dickoff/esp32-color-lamp-stand/README.md

# Color Lamp Stand — User Guide

This illuminated stand connects to Wi-Fi and uses its 32 LEDs to show whether
a stock selected in the firmware is up or down: green for up, red for down, and
white when no current value is available. The stock cannot currently be changed
through the Wi-Fi setup page.

This is the default behavior, but you could modify the software to do something
completely different or custom with the LEDs and the Internet connection.

## Hardware

You need:

- A USB-C wall charger and a USB-C-to-USB-C cable. For full brightness, use a
  charger that provides **5 V at 3 A**.

Good options are:

- This [Anker 20 W USB-C charger kit](https://www.amazon.com/dp/B0CP7NWH6L),
  which includes two compact chargers and two cables. Each charger provides
  5 V at 3 A.
- The inexpensive [IKEA SJÖSS 20 W USB-C charger](https://www.ikea.com/us/en/p/sjoess-20w-1-port-usb-charger-10618445/),
  which also provides 5 V at 3 A. Its USB-C cable is sold separately.

Either option provides enough power for the stand's highest brightness setting.
A computer USB-C port also works, but the stand may automatically use a lower
brightness if the port advertises less available current.

Feed the cable through the base and tie a loose knot inside for strain relief,
as shown below. Do not pull the knot tight enough to damage the cable.

Knot in USB-C cable for strain relief

Connect the USB-C plug to the socket on the circuit board.

USB-C cable plugged into the circuit board

Fit the translucent cover, then place the object you want to illuminate on top.

## Wi-Fi configuration

On first use, an amber wave travels around the stand and it creates a temporary
Wi-Fi network named
`ColorLamp-Setup-XXXX`, where the last four characters are unique to your stand.

1. On a phone, tablet, or computer, open Wi-Fi settings and join that network.
   It intentionally has no password and may be described by your device as
   having no internet.
2. The setup page should open automatically. If it does not, open
   [http://192.168.4.1](http://192.168.4.1) in a web browser.
3. Select your home Wi-Fi network, enter its password, and choose **Connect**.
4. The stand pulses blue while it tests the connection. Green means setup
   succeeded and the stand will restart. Red means it could not connect; check
   the network and password, then try again.

Your Wi-Fi password is stored only on the stand.

### Changing the Wi-Fi network

With the stand fully started, hold the **BOOT** button on the circuit board for
five seconds. The LEDs turn red, the saved Wi-Fi details are erased, and the
stand restarts in setup mode.

Do not hold **BOOT** while plugging in power or pressing **RESET**. That button
also activates the ESP32's programming mode during startup.

## What the lights during startup mean

Every startup shows the power check, then the firmware version, then the Wi-Fi
status.

### Power check

Immediately after power-on, a short sweep reports how much current the connected
USB-C source advertises. The stand uses this information to limit LED brightness.
The sweep fills, pauses for about a second, and fades away.

USB-C power capability light patterns

- **8 amber LEDs — USB default:** The stand uses a conservative, low-brightness
  limit. For better illumination, try a USB-C charger rated for at least 1.5 A.
- **16 cyan LEDs — 1.5 A:** Normal operation with good available brightness.
- **32 green LEDs — 3 A:** The source advertises the highest supported current.
- **Two red flashes, then 8 amber LEDs:** The stand could not read the source
  capability and safely selected the conservative limit.

This is the capability advertised by the power source, not a measurement of how
much current the stand is presently consuming.

### Firmware version

After the power check, three short displays show the firmware version in
**major.minor.patch** order. Count only the **bright white LEDs** in each display.
The rest of the ring glows dimly in a background color to identify the part:

- **Blue background:** Major version.
- **Purple background:** Minor version.
- **Amber background:** Patch version.

For example, version **2.2.0** shows two white LEDs on blue, two white LEDs on
purple, then an entirely dim amber ring. **No white LEDs means zero**—the colored
background still appears.

### Wi-Fi and setup

After the version display, the entire perimeter shows the Wi-Fi state.

Wi-Fi setup and connection light patterns

- **Solid blue:** Connecting to the saved Wi-Fi network.
- **Slow amber wave (one lap every four seconds):** Waiting for you to join
  `ColorLamp-Setup-XXXX` and complete setup.
- **Pulsing blue:** Testing the Wi-Fi name and password you entered.
- **Solid green:** Connected successfully. After initial setup, the stand soon
  restarts automatically.
- **Solid red:** The attempted Wi-Fi connection failed.
- **Bright red after holding BOOT:** Saved Wi-Fi details are being erased.

## Troubleshooting

- **The setup page did not open:** Stay connected to `ColorLamp-Setup-XXXX` and
  open [http://192.168.4.1](http://192.168.4.1) manually. Temporarily disabling
  cellular data or a VPN can help if the phone leaves the setup network.
- **The stand keeps returning to amber setup mode:** Re-enter the Wi-Fi password
  and make sure the selected network is available where the stand will be used.
- **The light is unusually dim:** Check the power-on sweep. Eight amber LEDs mean
  the power source advertised only the default USB current; try another USB-C
  charger and cable.
- **You need to start over:** Let the stand finish booting, then hold **BOOT** for
  five seconds.

## Want to modify it?

The hardware and especially firmware are open for experimentation. See the
[modification guide](MODIFYING.md) for the source layout, fixed GPIO assignments,
KiCad design overview, and build workflow.

If you're working with an AI coding agent, point it at this repository and ask
it to read [MODIFYING.md](MODIFYING.md) before making changes.
