dickoff/esp32-color-lamp-stand/pcb/esp32-color-lamp-stand.kicad_pcb

## KiCad design pcb/esp32-color-lamp-stand.kicad_pcb (2026-09-15)

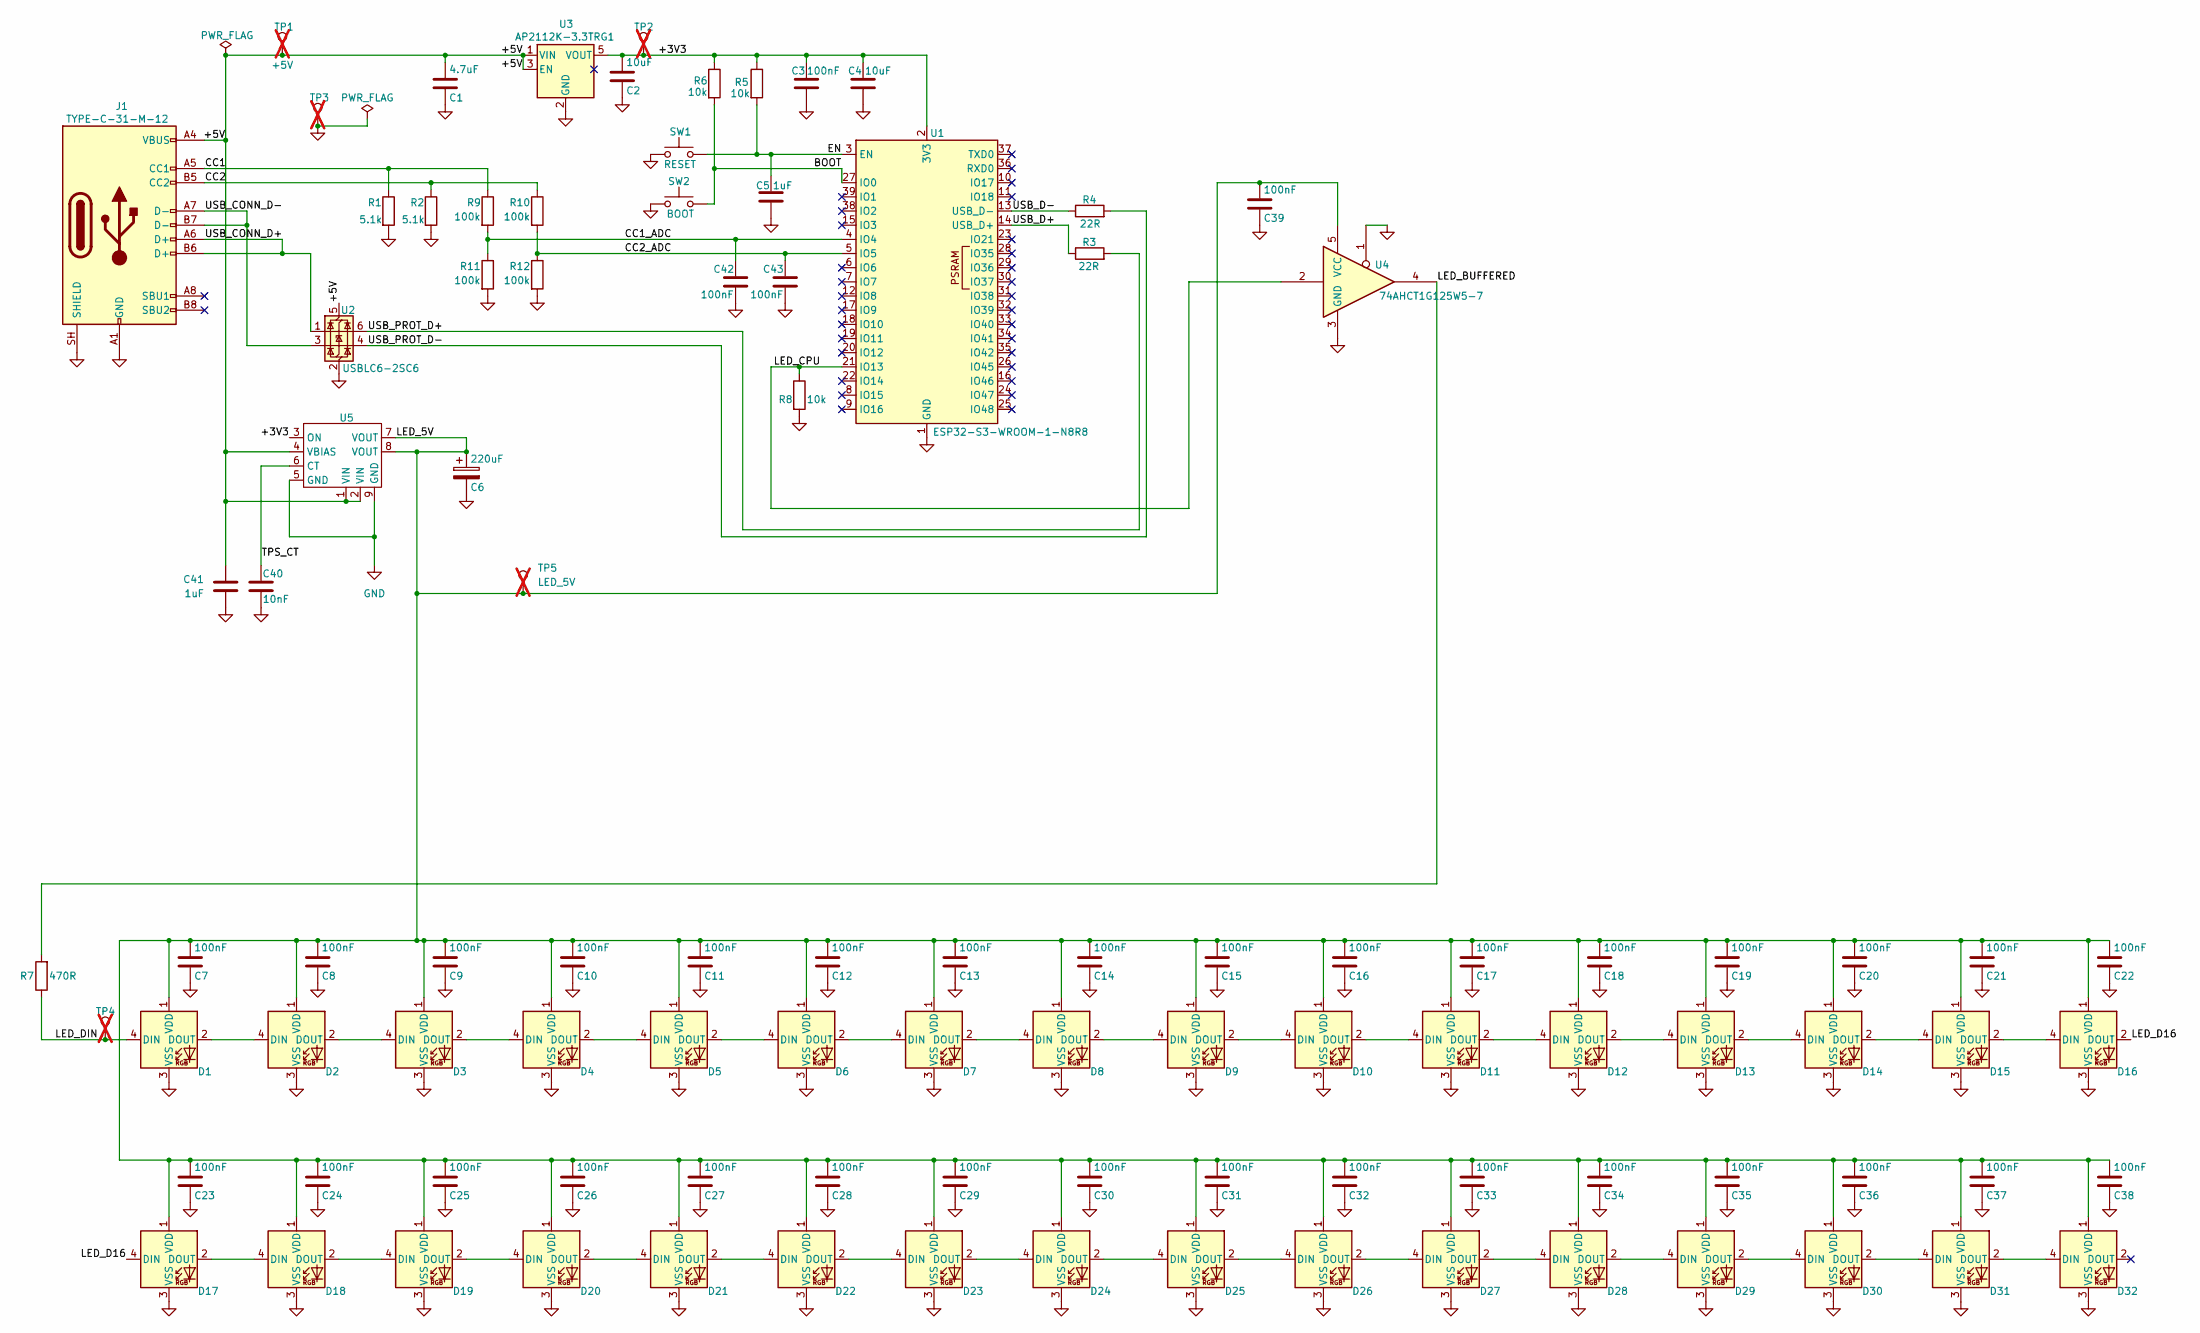
[picture p6: schematic esp32-color-lamp-stand.kicad_sch]

Parts:
C1: 4.7uF; C_0805_2012Metric; Manufacturer Part Number 4.7uF; LCSC C1779
C2, C4: 10uF; C_0805_2012Metric; Manufacturer Part Number 10uF; LCSC C15850
C3, C7, C8, C9, C10, C11, C12, C13, C14, C15, C16, C17, C18, C19, C20, C21, C22, C23, C24, C25, C26, C27, C28, C29, C30, C31, C32, C33, C34, C35, C36, C37, C38, C39: 100nF; C_0603_1608Metric; Manufacturer Part Number 100nF; LCSC C14663
C5: 1uF; C_0603_1608Metric; Manufacturer Part Number 1uF; LCSC C15849
C6: 220uF; C_Elec_6.3x5.8; Manufacturer Part Number RVT1A221M0605; LCSC C3345
C40: 10nF; C_0603_1608Metric; Manufacturer Part Number 10nF; LCSC C57112
C41: 1uF; C_0603_1608Metric; LCSC C15849
C42, C43: 100nF; C_0603_1608Metric; LCSC C14663
D1, D2, D3, D4, D5, D6, D7, D8, D9, D10, D11, D12, D13, D14, D15, D16, D17, D18, D19, D20, D21, D22, D23, D24, D25, D26, D27, D28, D29, D30, D31, D32: XL-5050RGBC-2812B-S; LED_WS2812B_PLCC4_5.0x5.0mm_P3.2mm; Manufacturer Part Number XL-5050RGBC-2812B-S; LCSC C22461793
J1: TYPE-C-31-M-12; USB_C_Receptacle_HRO_TYPE-C-31-M-12; Manufacturer Part Number TYPE-C-31-M-12; LCSC C165948
R1, R2: 5.1k; R_0603_1608Metric; Manufacturer Part Number 5.1k; LCSC C23186
R3, R4: 22R; R_0603_1608Metric; Manufacturer Part Number 22R; LCSC C23345
R5, R6, R8: 10k; R_0603_1608Metric; Manufacturer Part Number 10k; LCSC C25804
R7: 470R; R_0603_1608Metric; Manufacturer Part Number 470R; LCSC C23179
R9, R10, R11, R12: 100k; R_0603_1608Metric; Manufacturer Part Number 100k; LCSC C25803
SW1: RESET; SW_Push_1P1T_XKB_TS-1187A; Manufacturer Part Number TS-1187A-B-A-B; LCSC C318884
SW2: BOOT; SW_Push_1P1T_XKB_TS-1187A; Manufacturer Part Number TS-1187A-B-A-B; LCSC C318884
TP1: +5V; TestPoint_Pad_D1.0mm; not fitted
TP2: +3V3; TestPoint_Pad_D1.0mm; not fitted
TP3: GND; TestPoint_Pad_D1.0mm; not fitted
TP4: LED_DIN; TestPoint_Pad_D1.0mm; not fitted
TP5: LED_5V; TestPoint_Pad_D1.0mm; not fitted
U1: ESP32-S3-WROOM-1-N8R8; ESP32-S3-WROOM-1; Manufacturer Part Number ESP32-S3-WROOM-1-N8R8; LCSC C2913201
U2: USBLC6-2SC6; SOT-23-6; Manufacturer Part Number USBLC6-2SC6; LCSC C7519
U3: AP2112K-3.3TRG1; SOT-23-5; Manufacturer Part Number AP2112K-3.3TRG1; LCSC C23380830
U4: 74AHCT1G125W5-7; SOT-23-5; Manufacturer Part Number 74AHCT1G125W5-7; LCSC C842287
U5: TPS22975DSGR; Texas_DSG0008A_WSON-8-1EP_2x2mm_P0.5mm_EP0.9x1.6mm; Manufacturer Part Number TPS22975DSGR; LCSC C524777

Connections:
/+3V3: C2.1, C3.1, C4.1, R5.1, R6.1, TP2.1 (1_1), U1.2 (3V3), U3.5 (VOUT), U5.3 (ON)
/+5V: C1.1, C41.1, J1.A4 (VBUS), J1.A9 (VBUS), J1.B4 (VBUS), J1.B9 (VBUS), TP1.1 (1_1), U2.5 (VBUS), U3.1 (VIN), U3.3 (EN), U5.1 (VIN), U5.2 (VIN), U5.4 (VBIAS)
/BOOT: R6.2, SW2.2, U1.27 (IO0)
/CC1: J1.A5 (CC1), R1.1, R9.1
/CC1_ADC: C42.1, R9.2, R11.1, U1.4 (IO4)
/CC2: J1.B5 (CC2), R2.1, R10.1
/CC2_ADC: C43.1, R10.2, R12.1, U1.5 (IO5)
/EN: C5.1, R5.2, SW1.2, U1.3 (EN)
/LED_5V: C6.1, C7.1, C8.1, C9.1, C10.1, C11.1, C12.1, C13.1, C14.1, C15.1, C16.1, C17.1, C18.1, C19.1, C20.1, C21.1, C22.1, C23.1, C24.1, C25.1, C26.1, C27.1, C28.1, C29.1, C30.1, C31.1, C32.1, C33.1, C34.1, C35.1, C36.1, C37.1, C38.1, C39.1, D1.1 (VDD), D2.1 (VDD), D3.1 (VDD), D4.1 (VDD), D5.1 (VDD), D6.1 (VDD), D7.1 (VDD), D8.1 (VDD), D9.1 (VDD), D10.1 (VDD), D11.1 (VDD), D12.1 (VDD), D13.1 (VDD), D14.1 (VDD), D15.1 (VDD), D16.1 (VDD), D17.1 (VDD), D18.1 (VDD), D19.1 (VDD), D20.1 (VDD), D21.1 (VDD), D22.1 (VDD), D23.1 (VDD), D24.1 (VDD), D25.1 (VDD), D26.1 (VDD), D27.1 (VDD), D28.1 (VDD), D29.1 (VDD), D30.1 (VDD), D31.1 (VDD), D32.1 (VDD), TP5.1 (1_1), U4.5 (VCC), U5.7 (VOUT), U5.8 (VOUT)
/LED_BUFFERED: R7.2, U4.4
/LED_CPU: R8.1, U1.21 (IO13), U4.2
/LED_D16: D16.2 (DOUT), D17.4 (DIN)
/LED_DIN: D1.4 (DIN), R7.1, TP4.1 (1_1)
/TPS_CT: C40.1, U5.6 (CT)
/USB_CONN_D+: J1.A6 (D+), J1.B6 (D+), U2.1 (I/O1)
/USB_CONN_D-: J1.A7 (D-), J1.B7 (D-), U2.3 (I/O2)
/USB_D+: R3.1, U1.14 (USB_D+)
/USB_D-: R4.1, U1.13 (USB_D-)
/USB_PROT_D+: R3.2, U2.6 (I/O1)
/USB_PROT_D-: R4.2, U2.4 (I/O2)
GND: C1.2, C2.2, C3.2, C4.2, C5.2, C6.2, C7.2, C8.2, C9.2, C10.2, C11.2, C12.2, C13.2, C14.2, C15.2, C16.2, C17.2, C18.2, C19.2, C20.2, C21.2, C22.2, C23.2, C24.2, C25.2, C26.2, C27.2, C28.2, C29.2, C30.2, C31.2, C32.2, C33.2, C34.2, C35.2, C36.2, C37.2, C38.2, C39.2, C40.2, C41.2, C42.2, C43.2, D1.3 (VSS), D2.3 (VSS), D3.3 (VSS), D4.3 (VSS), D5.3 (VSS), D6.3 (VSS), D7.3 (VSS), D8.3 (VSS), D9.3 (VSS), D10.3 (VSS), D11.3 (VSS), D12.3 (VSS), D13.3 (VSS), D14.3 (VSS), D15.3 (VSS), D16.3 (VSS), D17.3 (VSS), D18.3 (VSS), D19.3 (VSS), D20.3 (VSS), D21.3 (VSS), D22.3 (VSS), D23.3 (VSS), D24.3 (VSS), D25.3 (VSS), D26.3 (VSS), D27.3 (VSS), D28.3 (VSS), D29.3 (VSS), D30.3 (VSS), D31.3 (VSS), D32.3 (VSS), J1.A1 (GND), J1.A12 (GND), J1.B1 (GND), J1.B12 (GND), J1.SH (SHIELD), R1.2, R2.2, R8.2, R11.2, R12.2, SW1.1, SW2.1, TP3.1 (1_1), U1.1 (GND), U1.40 (GND), U1.41 (GND), U2.2 (GND), U3.2 (GND), U4.1, U4.3 (GND), U5.5 (GND), U5.9 (GND)
unnamed: D1.2 (DOUT), D2.4 (DIN)
unnamed: D2.2 (DOUT), D3.4 (DIN)
unnamed: D3.2 (DOUT), D4.4 (DIN)
unnamed: D4.2 (DOUT), D5.4 (DIN)
unnamed: D5.2 (DOUT), D6.4 (DIN)
unnamed: D6.2 (DOUT), D7.4 (DIN)
unnamed: D7.2 (DOUT), D8.4 (DIN)
unnamed: D8.2 (DOUT), D9.4 (DIN)
unnamed: D9.2 (DOUT), D10.4 (DIN)
unnamed: D10.2 (DOUT), D11.4 (DIN)
unnamed: D11.2 (DOUT), D12.4 (DIN)
unnamed: D12.2 (DOUT), D13.4 (DIN)
unnamed: D13.2 (DOUT), D14.4 (DIN)
unnamed: D14.2 (DOUT), D15.4 (DIN)
unnamed: D15.2 (DOUT), D16.4 (DIN)
unnamed: D17.2 (DOUT), D18.4 (DIN)
unnamed: D18.2 (DOUT), D19.4 (DIN)
unnamed: D19.2 (DOUT), D20.4 (DIN)
unnamed: D20.2 (DOUT), D21.4 (DIN)
unnamed: D21.2 (DOUT), D22.4 (DIN)
unnamed: D22.2 (DOUT), D23.4 (DIN)
unnamed: D23.2 (DOUT), D24.4 (DIN)
unnamed: D24.2 (DOUT), D25.4 (DIN)
unnamed: D25.2 (DOUT), D26.4 (DIN)
unnamed: D26.2 (DOUT), D27.4 (DIN)
unnamed: D27.2 (DOUT), D28.4 (DIN)
unnamed: D28.2 (DOUT), D29.4 (DIN)
unnamed: D29.2 (DOUT), D30.4 (DIN)
unnamed: D30.2 (DOUT), D31.4 (DIN)
unnamed: D31.2 (DOUT), D32.4 (DIN)

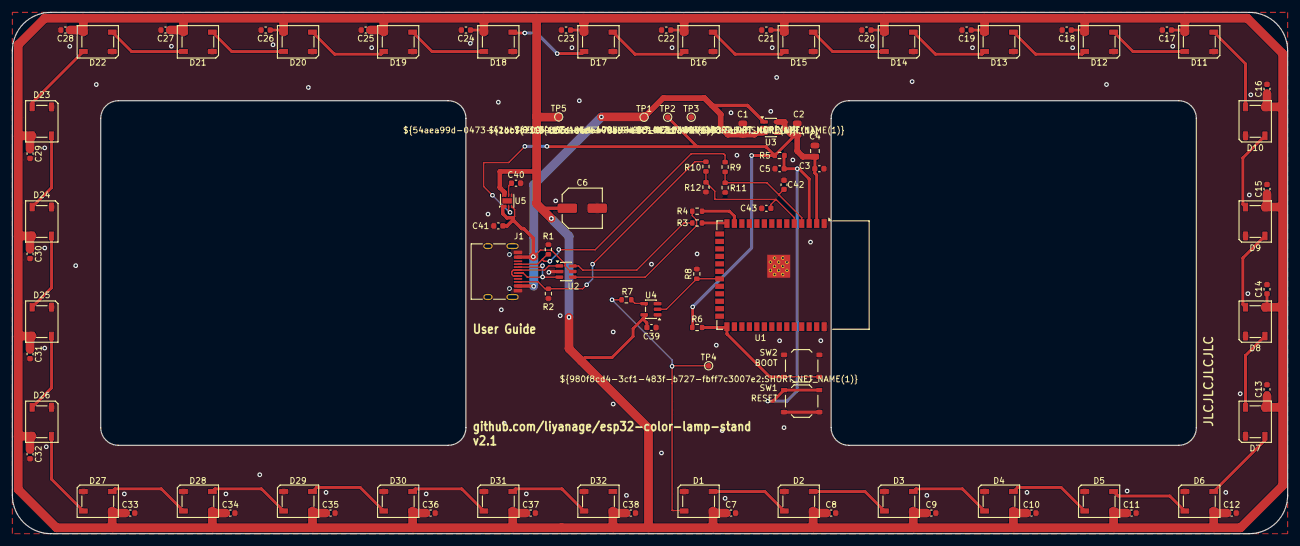
[picture p7: board esp32-color-lamp-stand.kicad_pcb from above]

Board: 2 copper layers, 216.5 x 88.5 mm, 100 parts (0 on the bottom side), 51 nets.
