dickoff/esp32-color-lamp-stand/(commit log)

2026-09-08 Move stock query off timer callback
2026-09-08 Correct TPS22975 pinout and routing
    [esp32-color-lamp-stand.kicad_pcb, esp32-color-lamp-stand.kicad_sch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]
2026-09-08 Remove obsolete Gerber exports
    [esp32-color-lamp-stand-B_Cu.gbr, esp32-color-lamp-stand-B_Mask.gbr, esp32-color-lamp-stand-B_Paste.gbr, esp32-color-lamp-stand-B_SilkS.gbr, esp32-color-lamp-stand-Edge_Cuts.gbr, esp32-color-lamp-stand-F_Cu.gbr, esp32-color-lamp-stand-F_Fab.gbr, esp32-color-lamp-stand-F_Mask.gbr]
2026-09-08 Update PCB silkscreen to v2.1
    [esp32-color-lamp-stand.kicad_pcb]
2026-09-08 Clean up PCB assembly metadata and power rules
    [esp32-color-lamp-stand.kicad_pcb, esp32-color-lamp-stand.kicad_sch]
2026-09-09 Add JLCPCB placement corrections
    [jlcpcb_cpl.csv]
2026-09-15 Add PCB user guide QR code
    [esp32-color-lamp-stand.kicad_pcb]
2026-09-17 Add firmware version display and finalize Wi-Fi setup wave
    Embed numeric firmware version 2.2.0 from version.txt independently of PCB tags and Git dirty state. Show major, minor, and patch counts as white LEDs on dim colored backgrounds after the USB power check, with slower timing and explicit zero indication. Set the seamless amber setup wave to a 15 percent minimum glow and document the startup indications.
2026-09-18 Add Mac batch flashing helper with verified board-swap checkpoints
    Build firmware once and flash a configurable number of ESP32-S3 stands using generated ESP-IDF flash arguments. Require unplugged acknowledgment between boards, reject ambiguous ports, and stop on failures. Use python3 consistently across Makefile targets and cover the helper with unit tests.
2026-09-19 Recommend suitable USB-C power supplies
